pietern/vdcmon/vdcmon.kicad_pcb

## KiCad design vdcmon.kicad_pcb (2017-03-19)

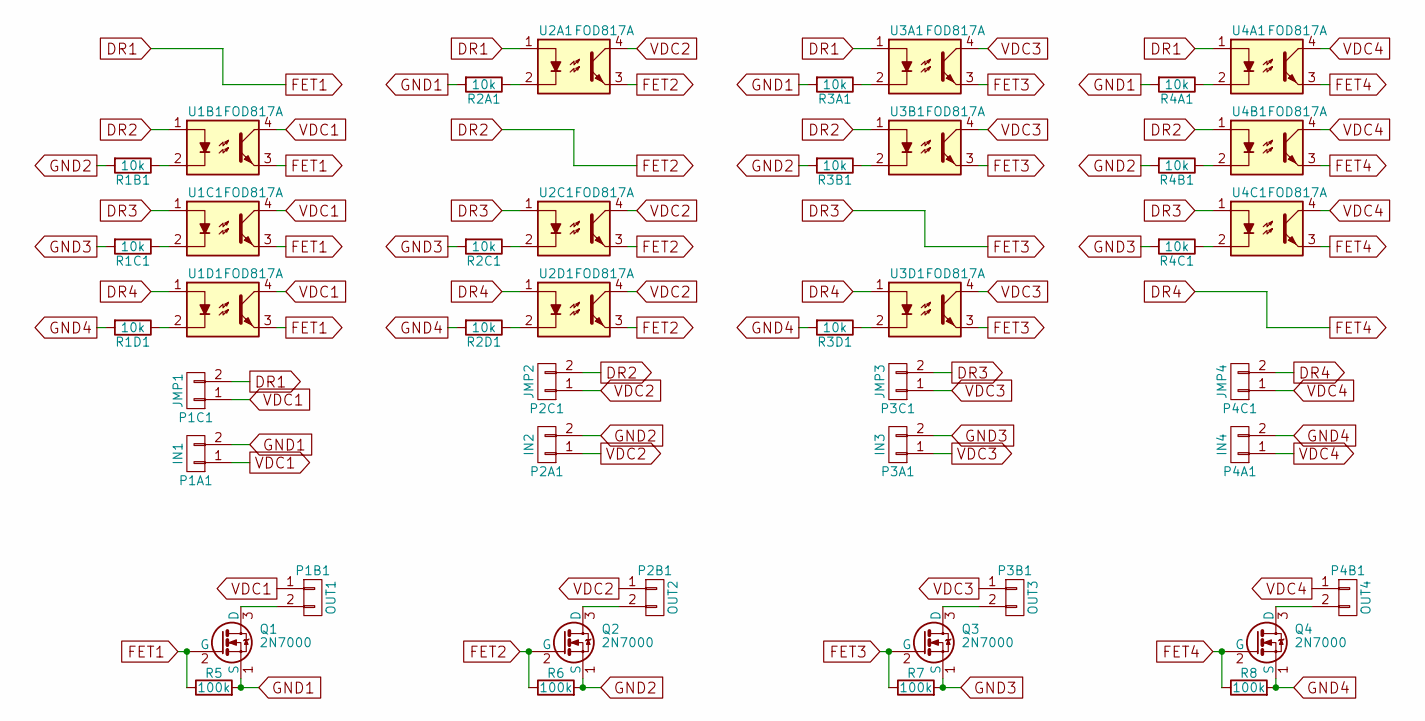
[picture p2: schematic vdcmon.sch, Voltage monitoring switchboard]

Parts:
P1A1: IN1; 26-350_CONN_2_plus_minus
P1B1: OUT1; 26-350_CONN_2_plus_minus
P1C1: JMP1; Pin_Header_Straight_1x02
P2A1: IN2; 26-350_CONN_2_plus_minus
P2B1: OUT2; 26-350_CONN_2_plus_minus
P2C1: JMP2; Pin_Header_Straight_1x02
P3A1: IN3; 26-350_CONN_2_plus_minus
P3B1: OUT3; 26-350_CONN_2_plus_minus
P3C1: JMP3; Pin_Header_Straight_1x02
P4A1: IN4; 26-350_CONN_2_plus_minus
P4B1: OUT4; 26-350_CONN_2_plus_minus
P4C1: JMP4; Pin_Header_Straight_1x02
Q1, Q2, Q3, Q4: 2N7000; TO-92_Inline_Narrow_Oval
R1B1, R1C1, R1D1, R2A1, R2C1, R2D1, R3A1, R3B1, R3D1, R4A1, R4B1, R4C1: 10k; R_Axial_DIN0207_L6.3mm_D2.5mm_P10.16mm_Horizontal
R5, R6, R7, R8: 100k; R_Axial_DIN0207_L6.3mm_D2.5mm_P10.16mm_Horizontal
U1B1, U1C1, U1D1, U2A1, U2C1, U2D1, U3A1, U3B1, U3D1, U4A1, U4B1, U4C1: FOD817A; DIP-4_W10.16mm

Connections:
DR1: P1C1.2, Q1.2 (G), R5.1, U1B1.3, U1C1.3, U1D1.3, U2A1.1, U3A1.1, U4A1.1
DR2: P2C1.2, Q2.2 (G), R6.1, U1B1.1, U2A1.3, U2C1.3, U2D1.3, U3B1.1, U4B1.1
DR3: P3C1.2, Q3.2 (G), R7.1, U1C1.1, U2C1.1, U3A1.3, U3B1.3, U3D1.3, U4C1.1
DR4: P4C1.2, Q4.2 (G), R8.1, U1D1.1, U2D1.1, U3D1.1, U4A1.3, U4B1.3, U4C1.3
GND1: P1A1.2, Q1.1 (S), R2A1.2, R3A1.2, R4A1.2, R5.2
GND2: P2A1.2, Q2.1 (S), R1B1.2, R3B1.2, R4B1.2, R6.2
GND3: P3A1.2, Q3.1 (S), R1C1.2, R2C1.2, R4C1.2, R7.2
GND4: P4A1.2, Q4.1 (S), R1D1.2, R2D1.2, R3D1.2, R8.2
unnamed: P1B1.2, Q1.3 (D)
unnamed: P2B1.2, Q2.3 (D)
unnamed: P3B1.2, Q3.3 (D)
unnamed: P4B1.2, Q4.3 (D)
unnamed: R1B1.1, U1B1.2
unnamed: R1C1.1, U1C1.2
unnamed: R1D1.1, U1D1.2
unnamed: R2A1.1, U2A1.2
unnamed: R2C1.1, U2C1.2
unnamed: R2D1.1, U2D1.2
unnamed: R3A1.1, U3A1.2
unnamed: R3B1.1, U3B1.2
unnamed: R3D1.1, U3D1.2
unnamed: R4A1.1, U4A1.2
unnamed: R4B1.1, U4B1.2
unnamed: R4C1.1, U4C1.2
VDC1: P1A1.1, P1B1.1, P1C1.1, U1B1.4, U1C1.4, U1D1.4
VDC2: P2A1.1, P2B1.1, P2C1.1, U2A1.4, U2C1.4, U2D1.4
VDC3: P3A1.1, P3B1.1, P3C1.1, U3A1.4, U3B1.4, U3D1.4
VDC4: P4A1.1, P4B1.1, P4C1.1, U4A1.4, U4B1.4, U4C1.4

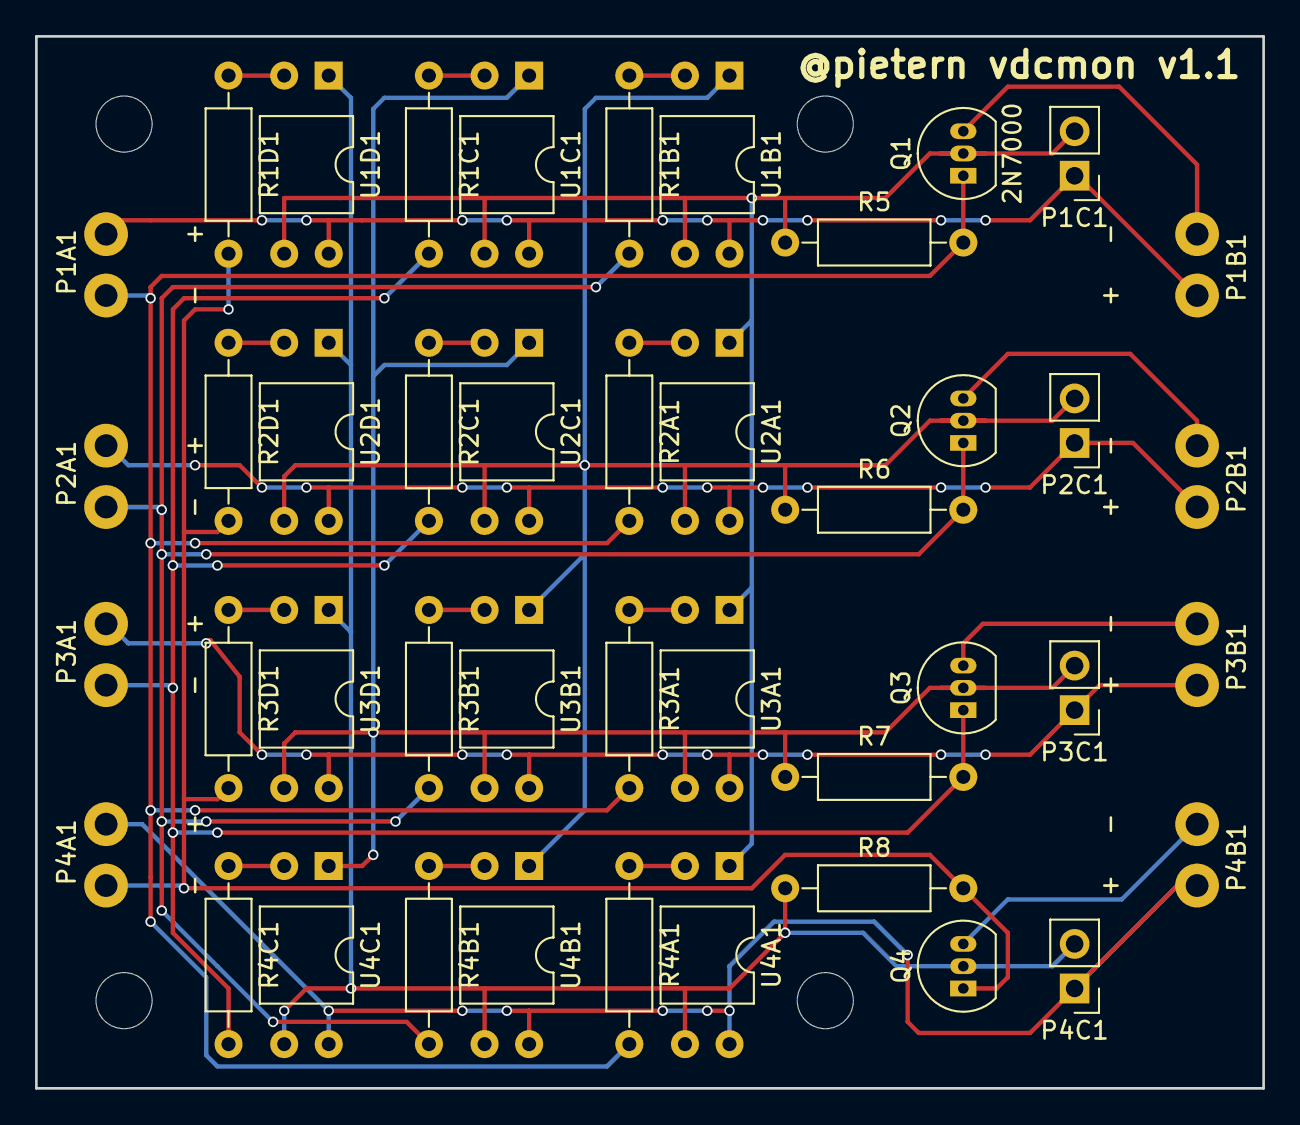
[picture p3: board vdcmon.kicad_pcb from above]

Board: 2 copper layers, 70.0 x 60.0 mm, 44 parts (0 on the bottom side), 28 nets.
