pietern/vdcmon/(commit log)

2017-03-19 Import vdcmon
    [vdcmon.kicad_pcb, vdcmon.sch]
2017-03-19 Add README and picture of assembled board
